decrazyo/solar-schlage-encode/README.md

# Solar Schlage Encode
This is a solar power mod for Schlage Encode smart locks.

## Tools
* 3D printer
* Screwdriver
* Wire strippers
* Soldering iron
* [Spot welder](https://www.amazon.com/dp/B0DBCZGL4P) (optional)

## Parts

* [500mAh LiPo battery](https://www.adafruit.com/product/1578)
* [Power wires with inline connector](https://www.adafruit.com/product/4720)
* [Solar charger board](https://www.adafruit.com/product/6106)
* [Solar panel](https://www.adafruit.com/product/5366)
* [7mm nickel strip](https://www.amazon.com/dp/B0DLGTQ156)
* [Outdoor rated hook and loop tape](https://www.amazon.com/dp/B09BNPHCZX)

## Build

### Battery Pack

3D print the replacement battery pack.  
Cut two 2cm (~3/4") lengths of nickel strip.  
Bend the nickel strips into 3 equal sized sections and insert them into battery pack.  
Fold the end of the nickel strips over each other and spot weld or solder them together.  

> [!NOTE]
> Spot welding is recommended over soldering.

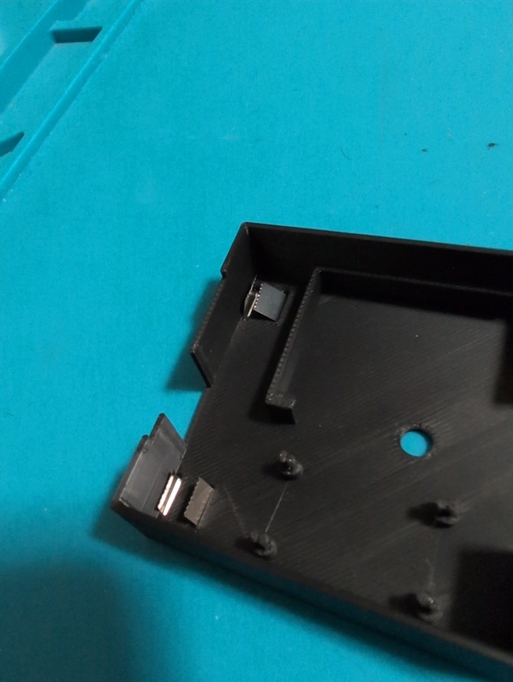
[picture p1: img/battery-pack1.jpg]
Battery pack with nickel strips


Cut the jumper on the back of the solar charger board to limit the charging current to 500mA.  

> [!CAUTION]
> Failure to cut the jumper may result overcharging the LiPo battery and burning your fucking house down! don't forget to cut the jumper!!!

Solder power wires with inline connector to the VIN and GND pins of the solar charger board.  

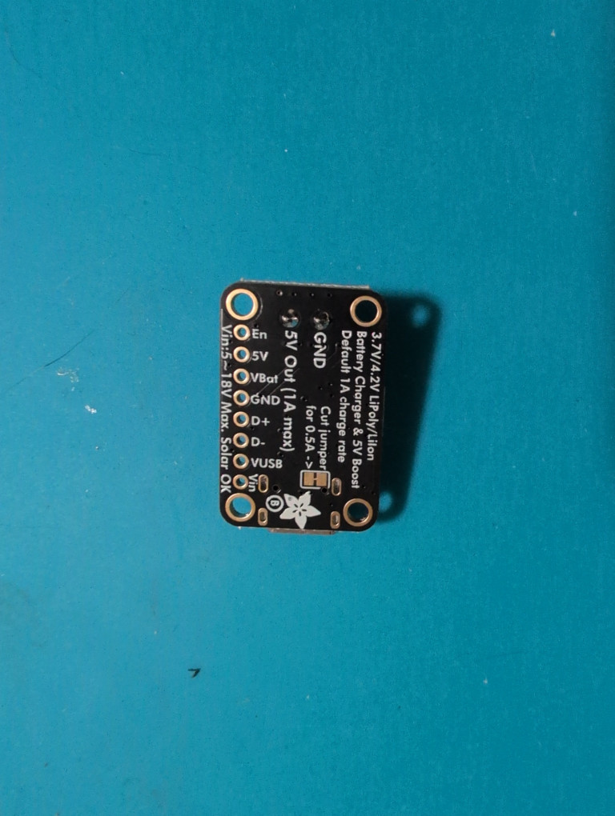
[picture p2: img/charge-board1.jpg]
Back of solar charge board


Mount the solar charger board in the battery pack and melt the pretension pins with a soldering iron.  

> [!NOTE]
> Use a low temperature on your soldering iron to melt the plastic. If you see smoke then your iron it too hot.

Connect the output terminals of the solar charger board to the battery pack contacts.  

> [!NOTE]
> Solder to the contacts in short bursts to avoid melting the 3D print too much.

Connect the 500mAh LiPo battery.

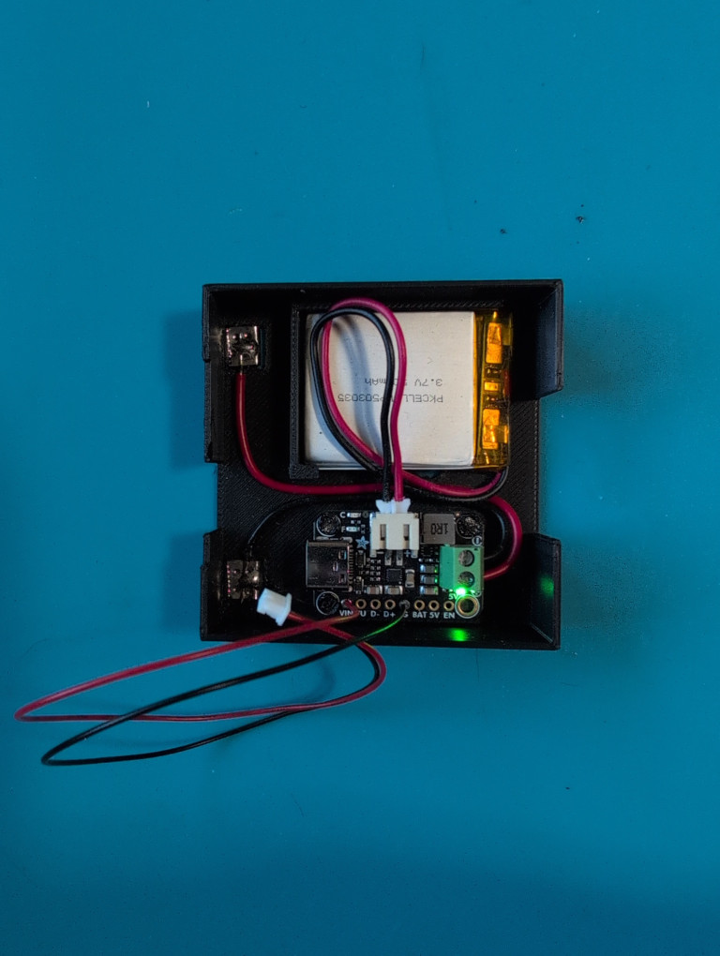
[picture p3: img/battery-pack2.jpg]
Finished battery pack


### Solar Panel

Remove the metal shield from the keypad.  

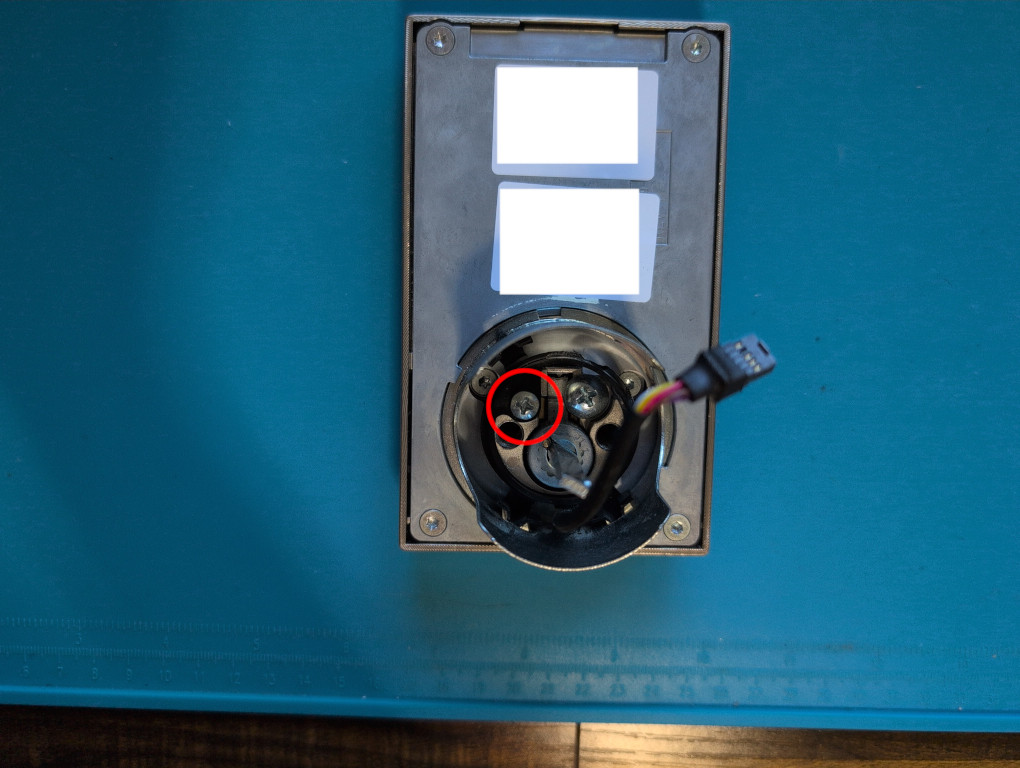
[picture p4: img/keypad1.jpg]
Back of keypad with metal shield in factory orientation


Remove the inner plastic piece from the metal shield reinstall it rotated 180 degrees.  

> [!NOTE]
> Take care to avoid breaking the plastic piece like I did.

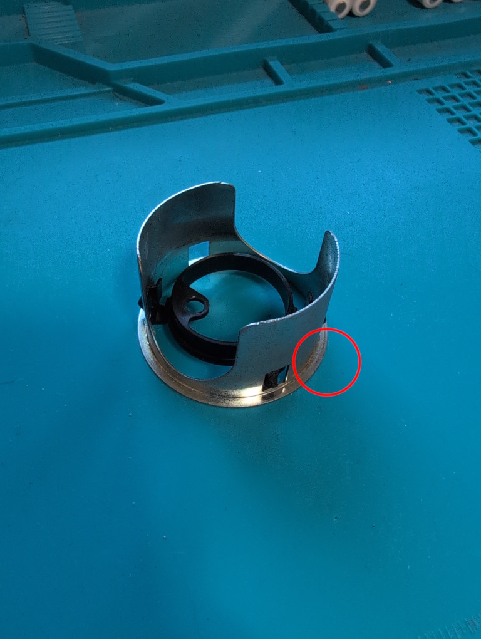
[picture p5: img/shield1.jpg]
Metal shield in factory orientation

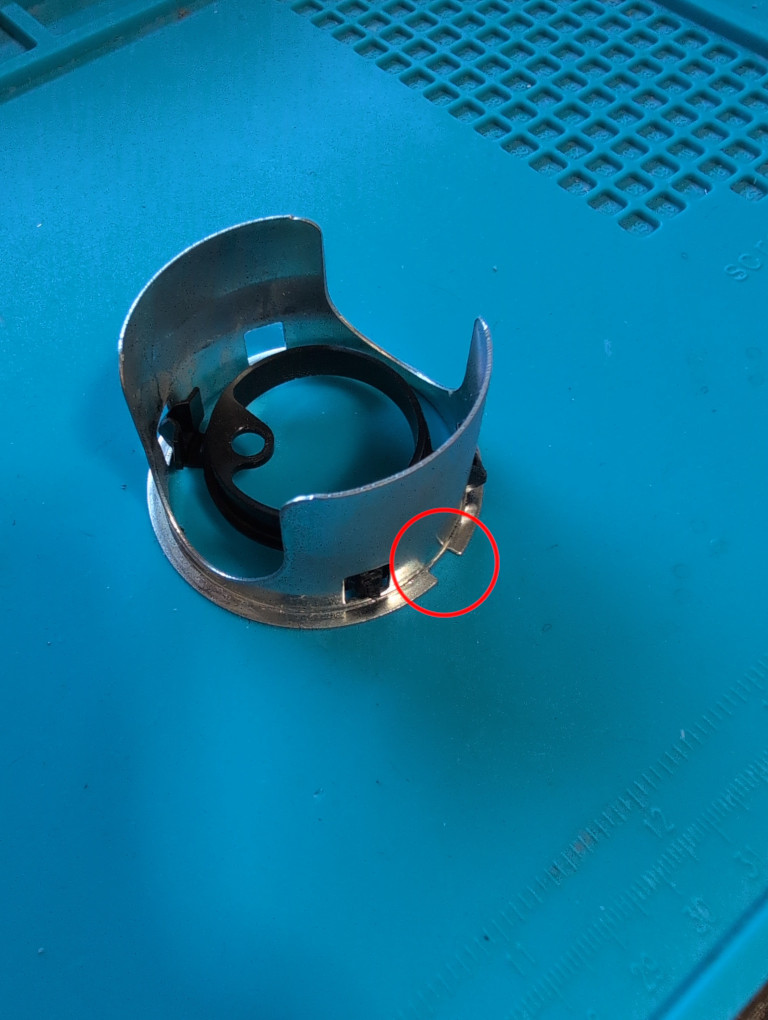
[picture p6: img/shield2.jpg]
Metal shield with plastic piece rotated


Reinstall the metal shield rotated 180 degrees, such that the notch lines up the the keypad's drain hole.  

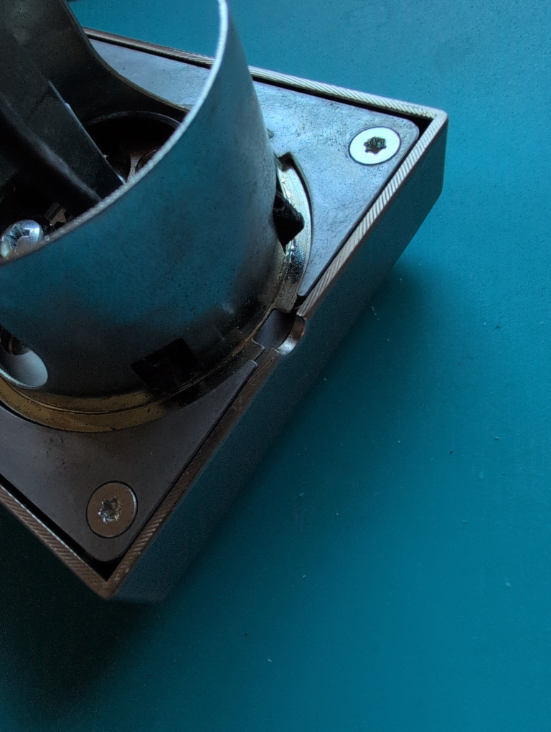
[picture p7: img/keypad2.jpg]
Back of keypad with metal shield rotated


Feed solar panel wires though the hole.  

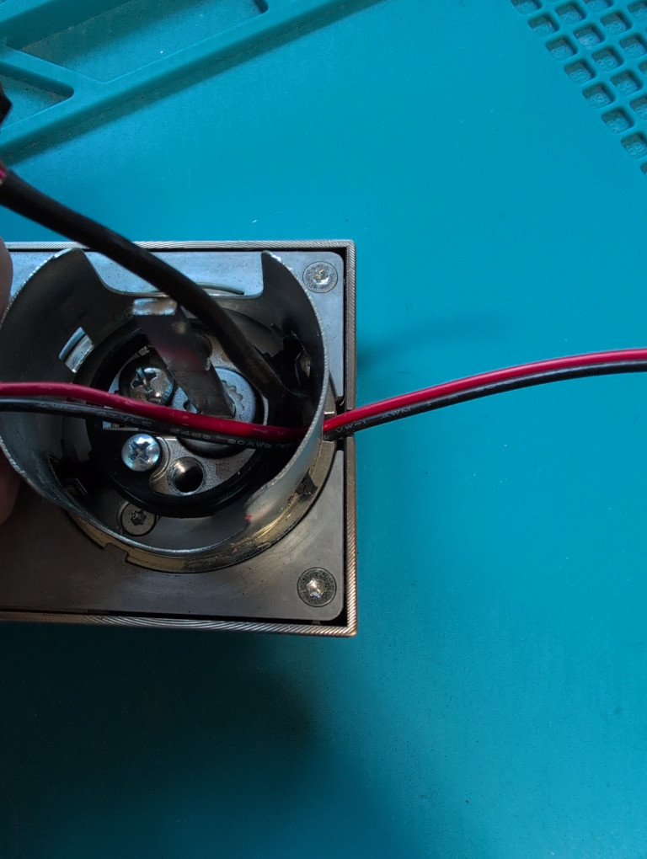
[picture p8: img/keypad3.jpg]
Back of keypad with wires routed


Solder on power wires with inline connector.  
Protect solder joints with heat shrink tubing.  

### Final Assembly

Route the solar panel wire into the battery compartment while reassembling the lock as you normally would.  

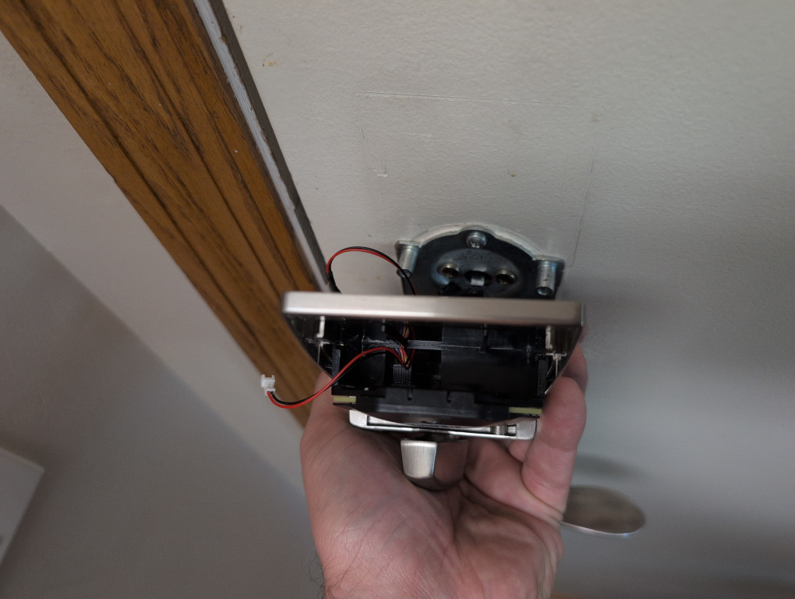
[picture p9: img/lock1.jpg]
Lock being reassembled with wires routed though it


Loosen this screw until it no longer extends into the battery compartment.  

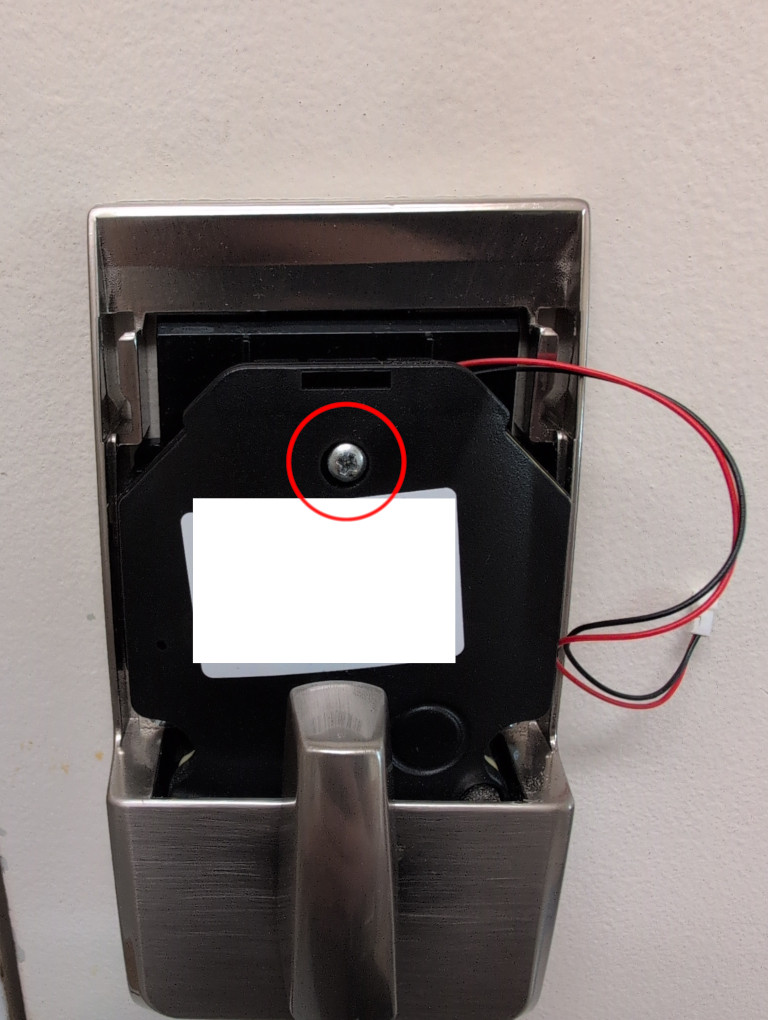
[picture p10: img/lock2.jpg]
Lock with indication of which screw to loosen


Connect the battery pack to the solar panel.  
Coil up excess wire inside the battery pack.  

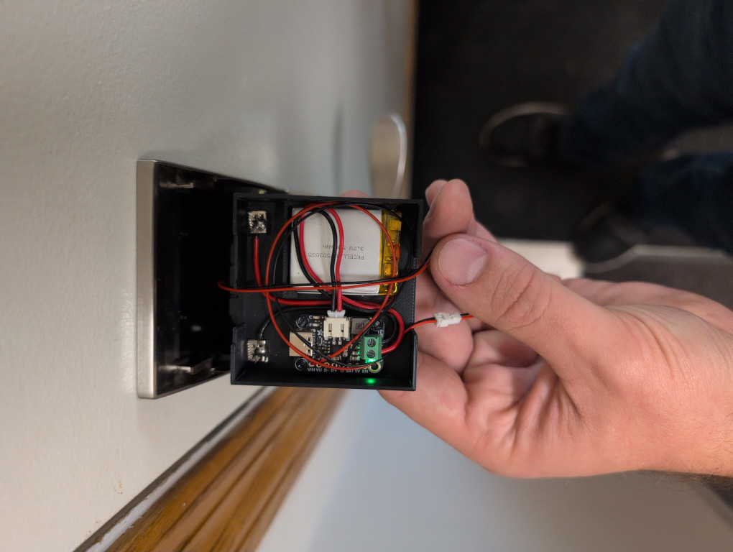
[picture p11: img/lock3.jpg]
Lock with battery pack ready to be installed


Insert the battery pack.

> [!NOTE]
> Holding lite upward pressure on the wires will make insertion easier.

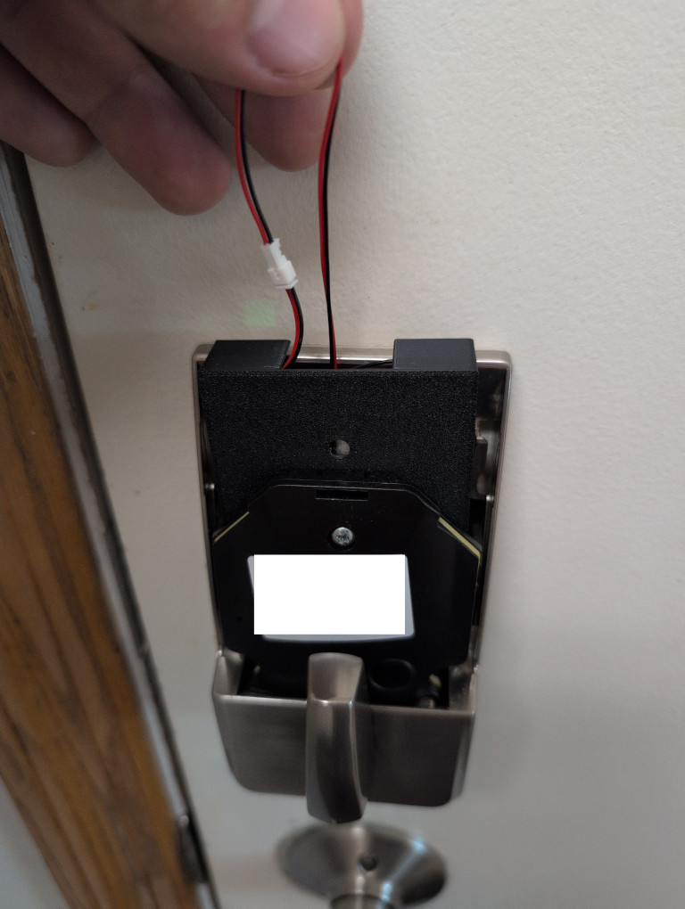
[picture p12: img/lock4.jpg]
Lock with battery pack being installed


Gently push excess wire into the battery pack.  

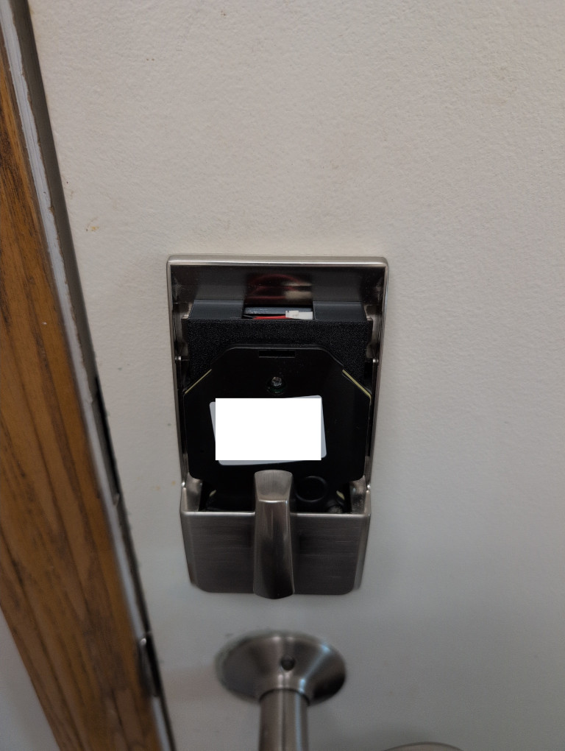
[picture p13: img/lock5.jpg]
Lock with battery pack installed


Tighten this screw again to lock the battery pack in place.  

Lock with indication of which screw to tighten

Mount the solar panel to the door with outdoor rated hook and loop tape.
