decrazyo/solar-schlage-encode/SchlageEncode.FCStd

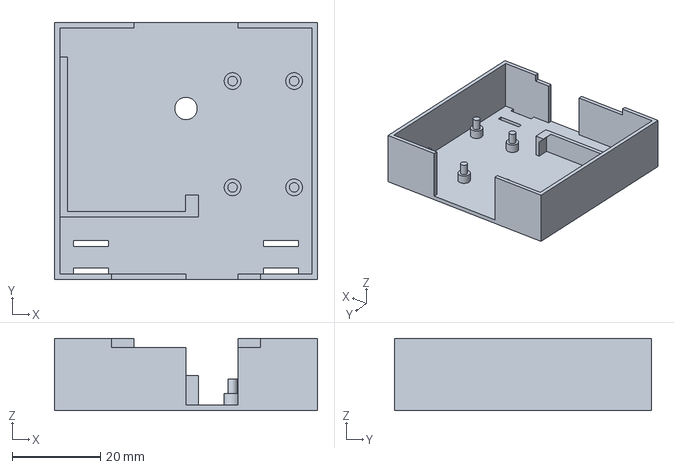
[picture p14: CAD file, 2026-11-13]
SchlageEncode.FCStd
59.7 x 58.4 x 16.4 mm
